kbs3056/proel-sniffer/captures/mso5354/README.md

# description

Raw captures (no logic level translation) made with Rigol MSO5354 in zipped CSV format.

DS0-DS5 - flat 44

DS6 - flat 38

DS0 - Long ring, no pick up, no open.

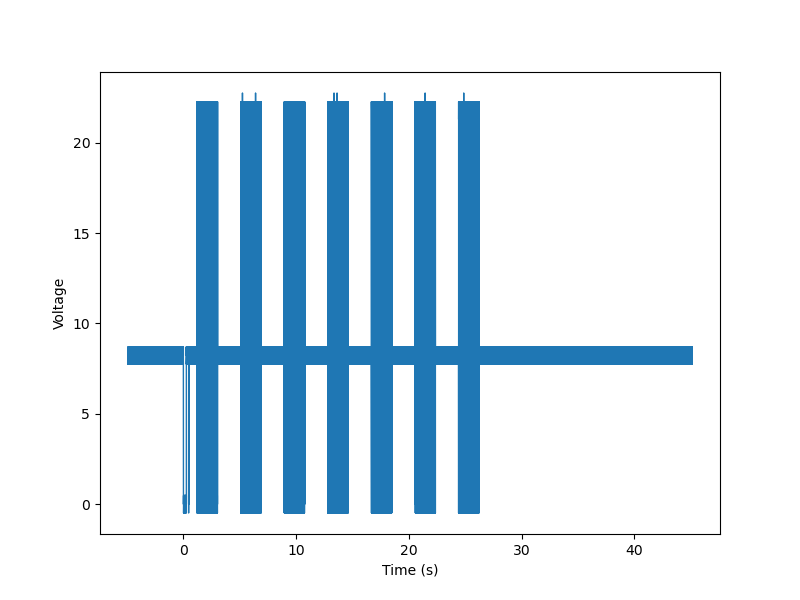
[picture p1: captures/mso5354/ds0.png]
ds0


DS1 - Ring, pick up, "hello", no open.

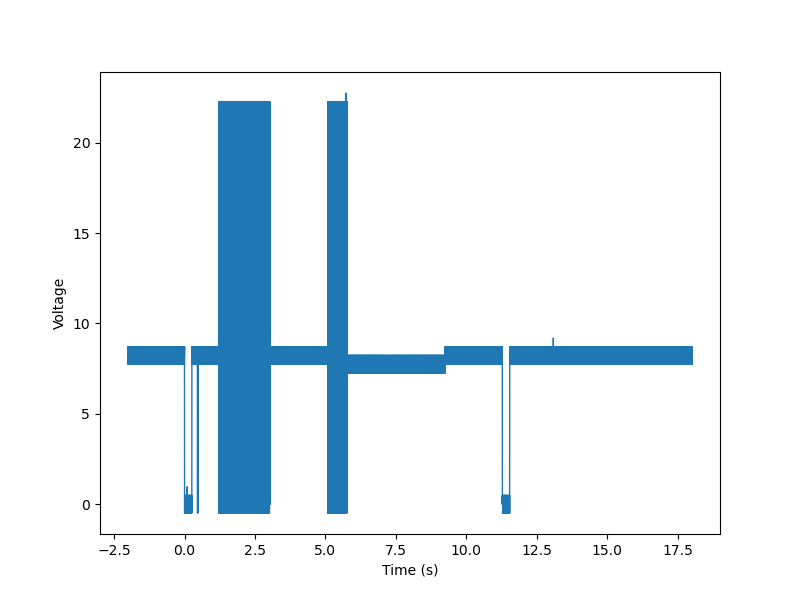
[picture p2: captures/mso5354/ds1.png]
ds1


DS2 - Ring, pick up, "hello", open.

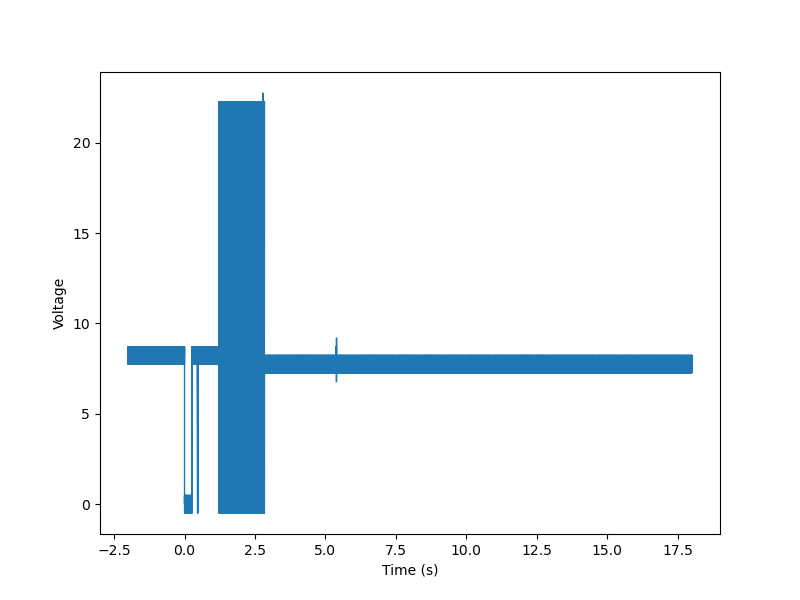
[picture p3: captures/mso5354/ds2.png]
ds2


DS3 - Ring, stopped with the entrance keyboard.

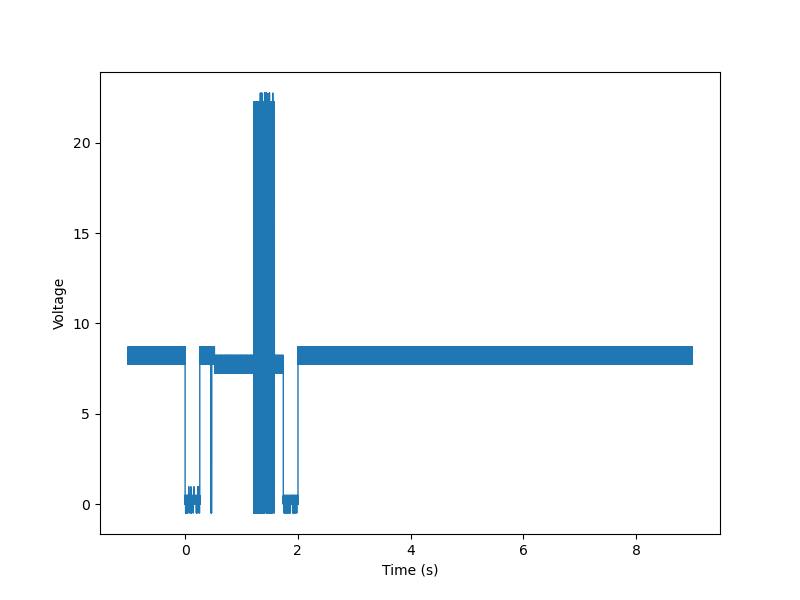
[picture p4: captures/mso5354/ds3.png]
ds3


DS4 - Open the door using a code.

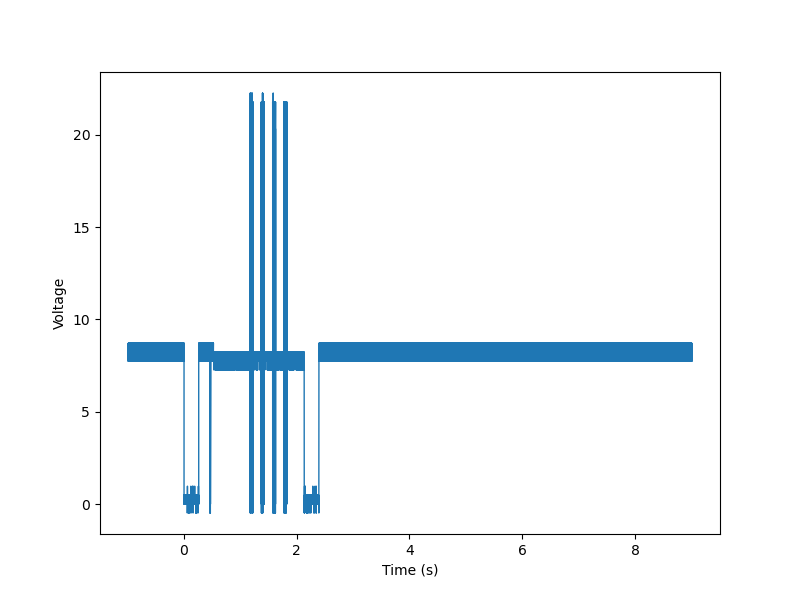
[picture p5: captures/mso5354/ds4.png]
ds4


DS5 - Open the door using a wireless keyfob.

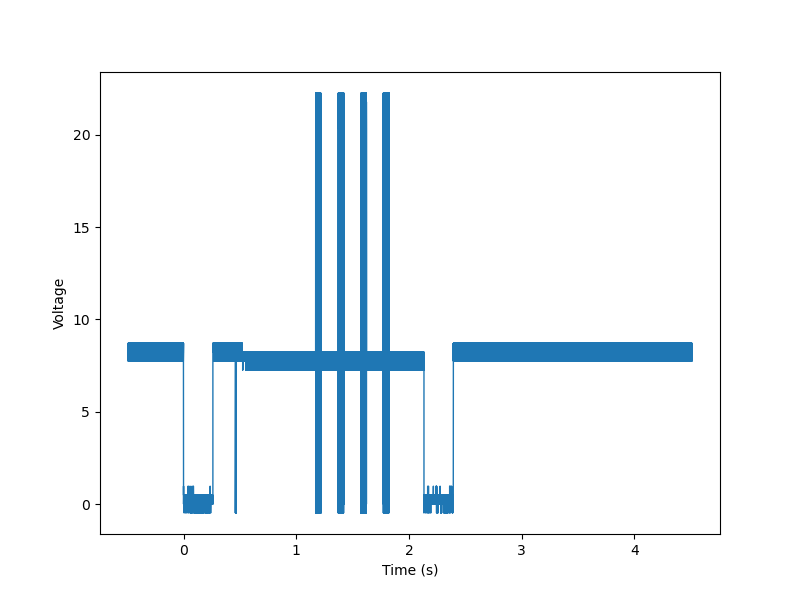
[picture p6: captures/mso5354/ds5.png]
ds5


DS6 - Ring, stop during the second "subring".

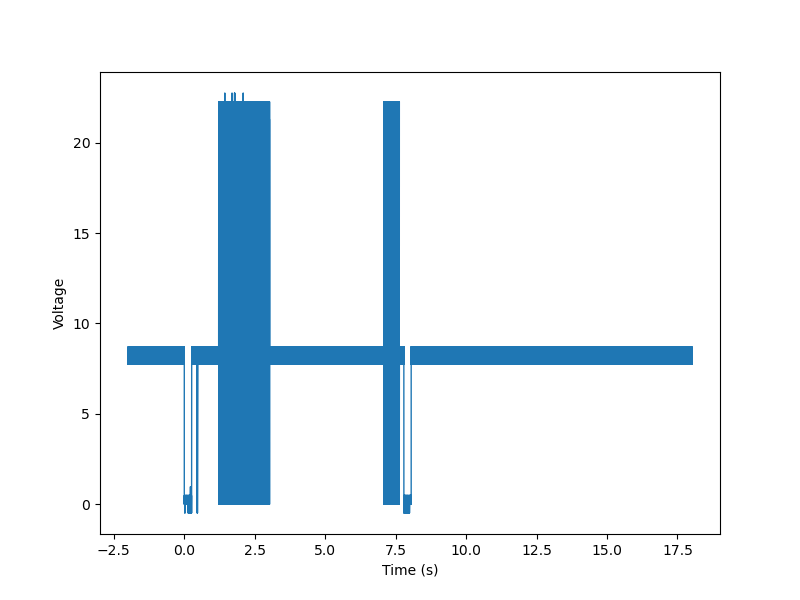
[picture p7: captures/mso5354/ds6.png]
ds6
