kbs3056/proel-sniffer/sniffer-wifi/sniffer-wifi_bot.png

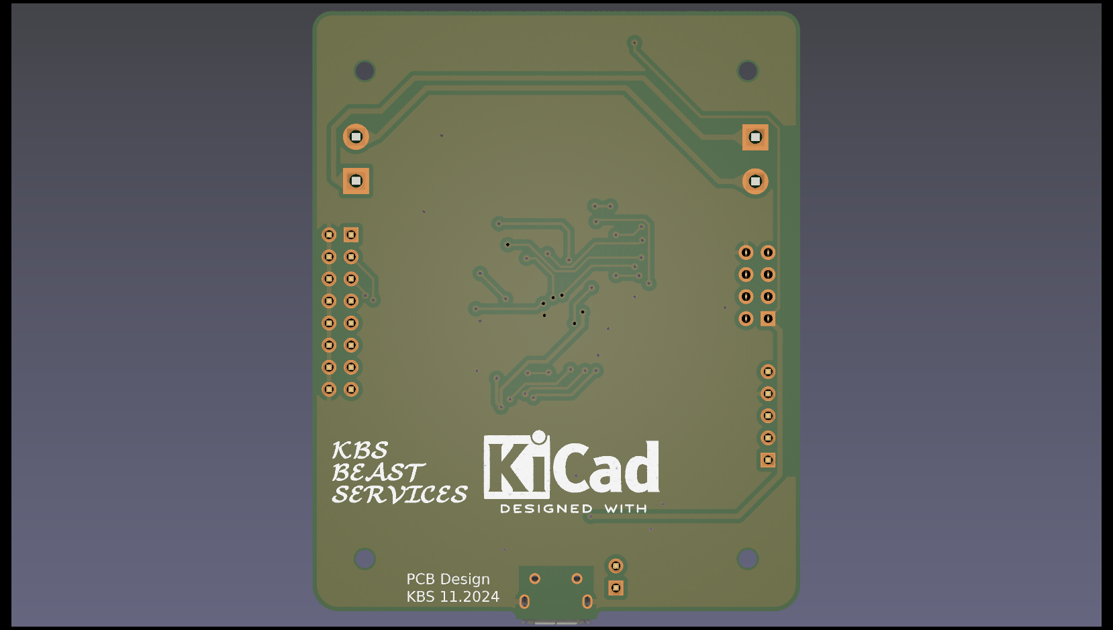
sniffer-wifi/sniffer-wifi_bot.png
