kbs3056/proel-sniffer/sniffer-wifi/sniffer-wifi_top.png

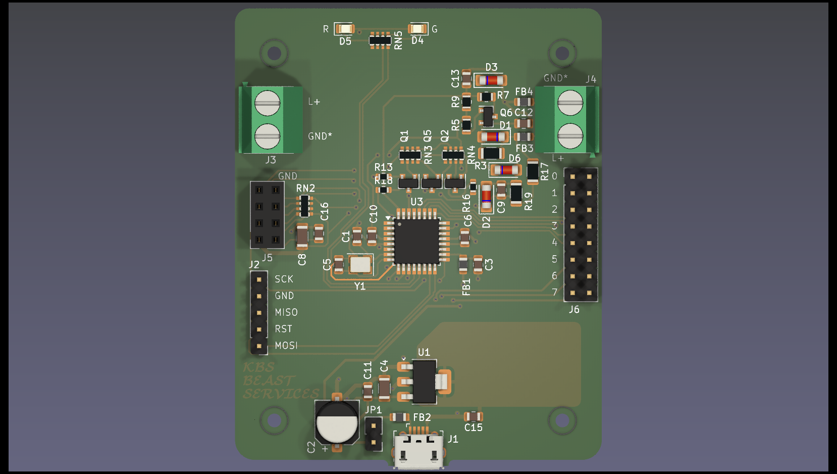
sniffer-wifi/sniffer-wifi_top.png
