kbs3056/proel-sniffer/sch.pdf

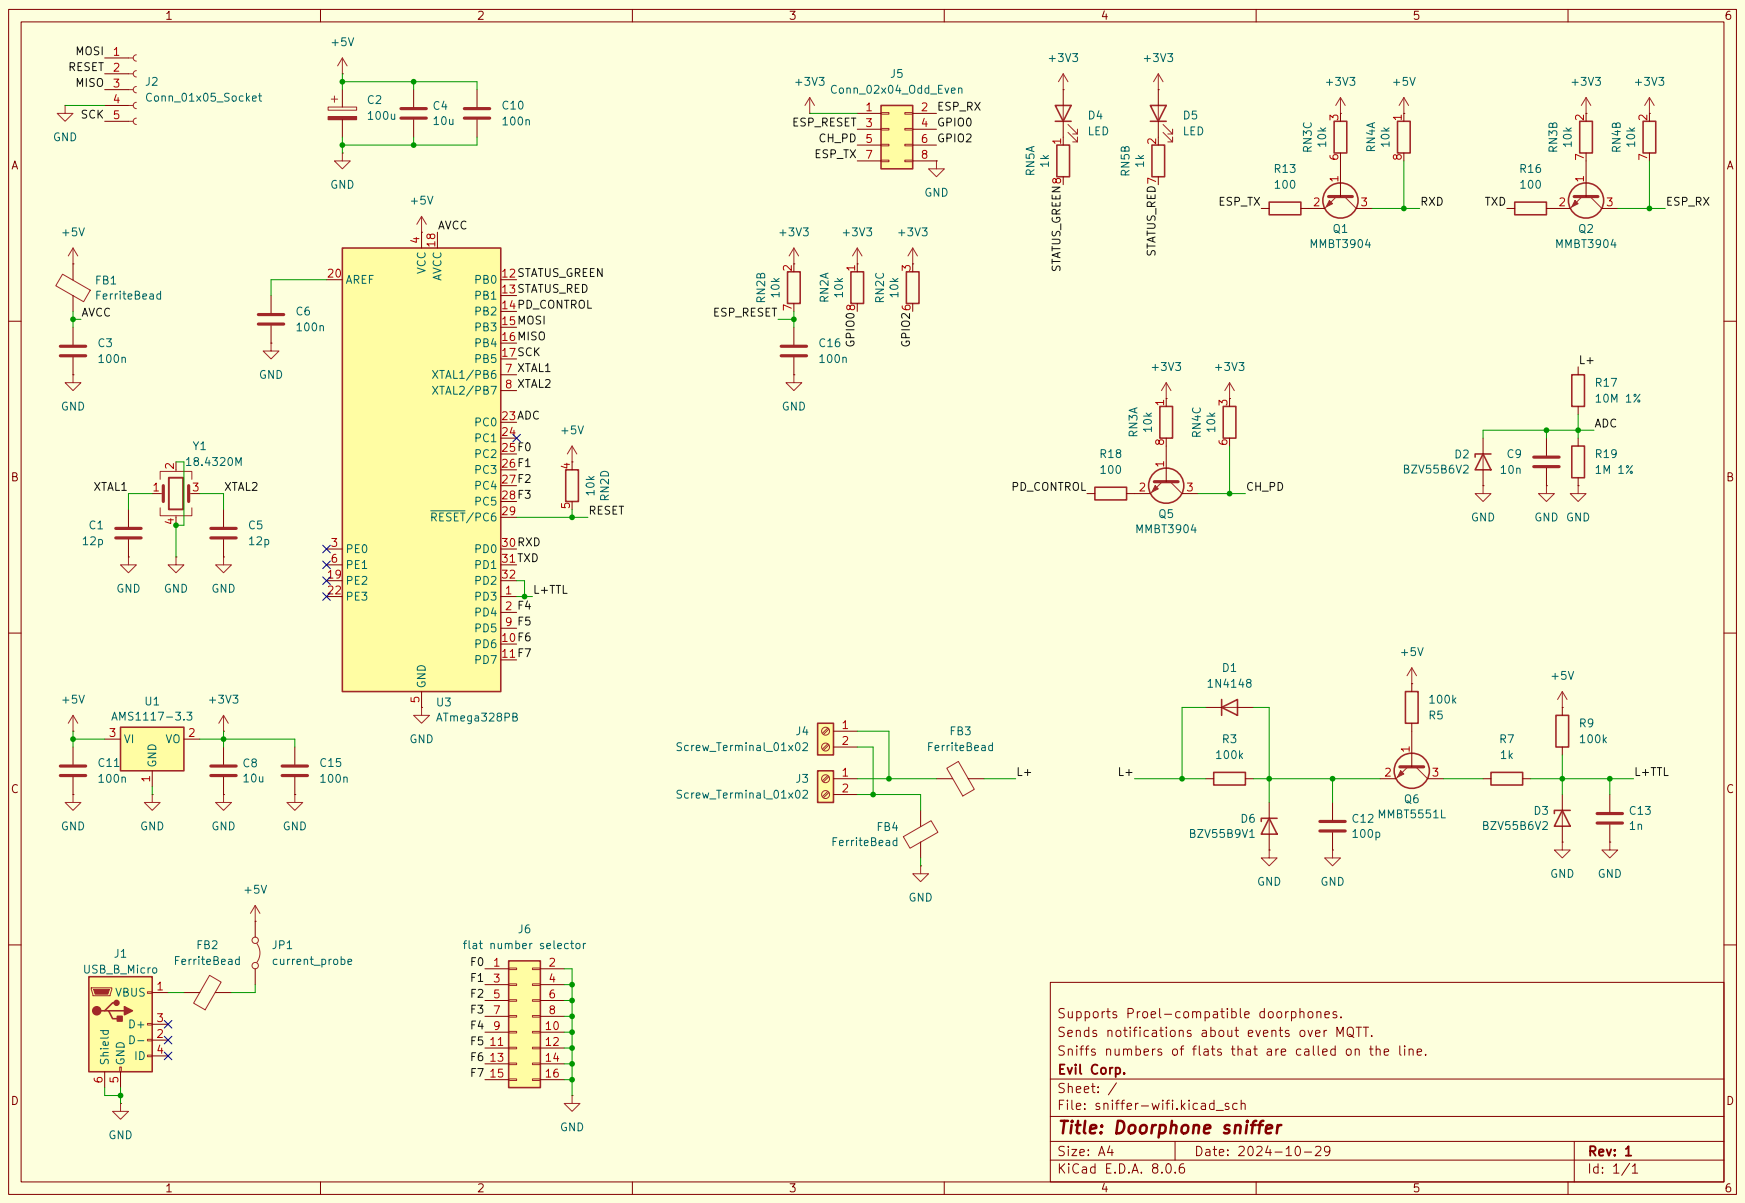
[picture p10: page 1]
