kbs3056/proel-sniffer/sniffer-wifi/sniffer-wifi.kicad_pcb

## KiCad design sniffer-wifi/sniffer-wifi.kicad_pcb (2024-11-15)

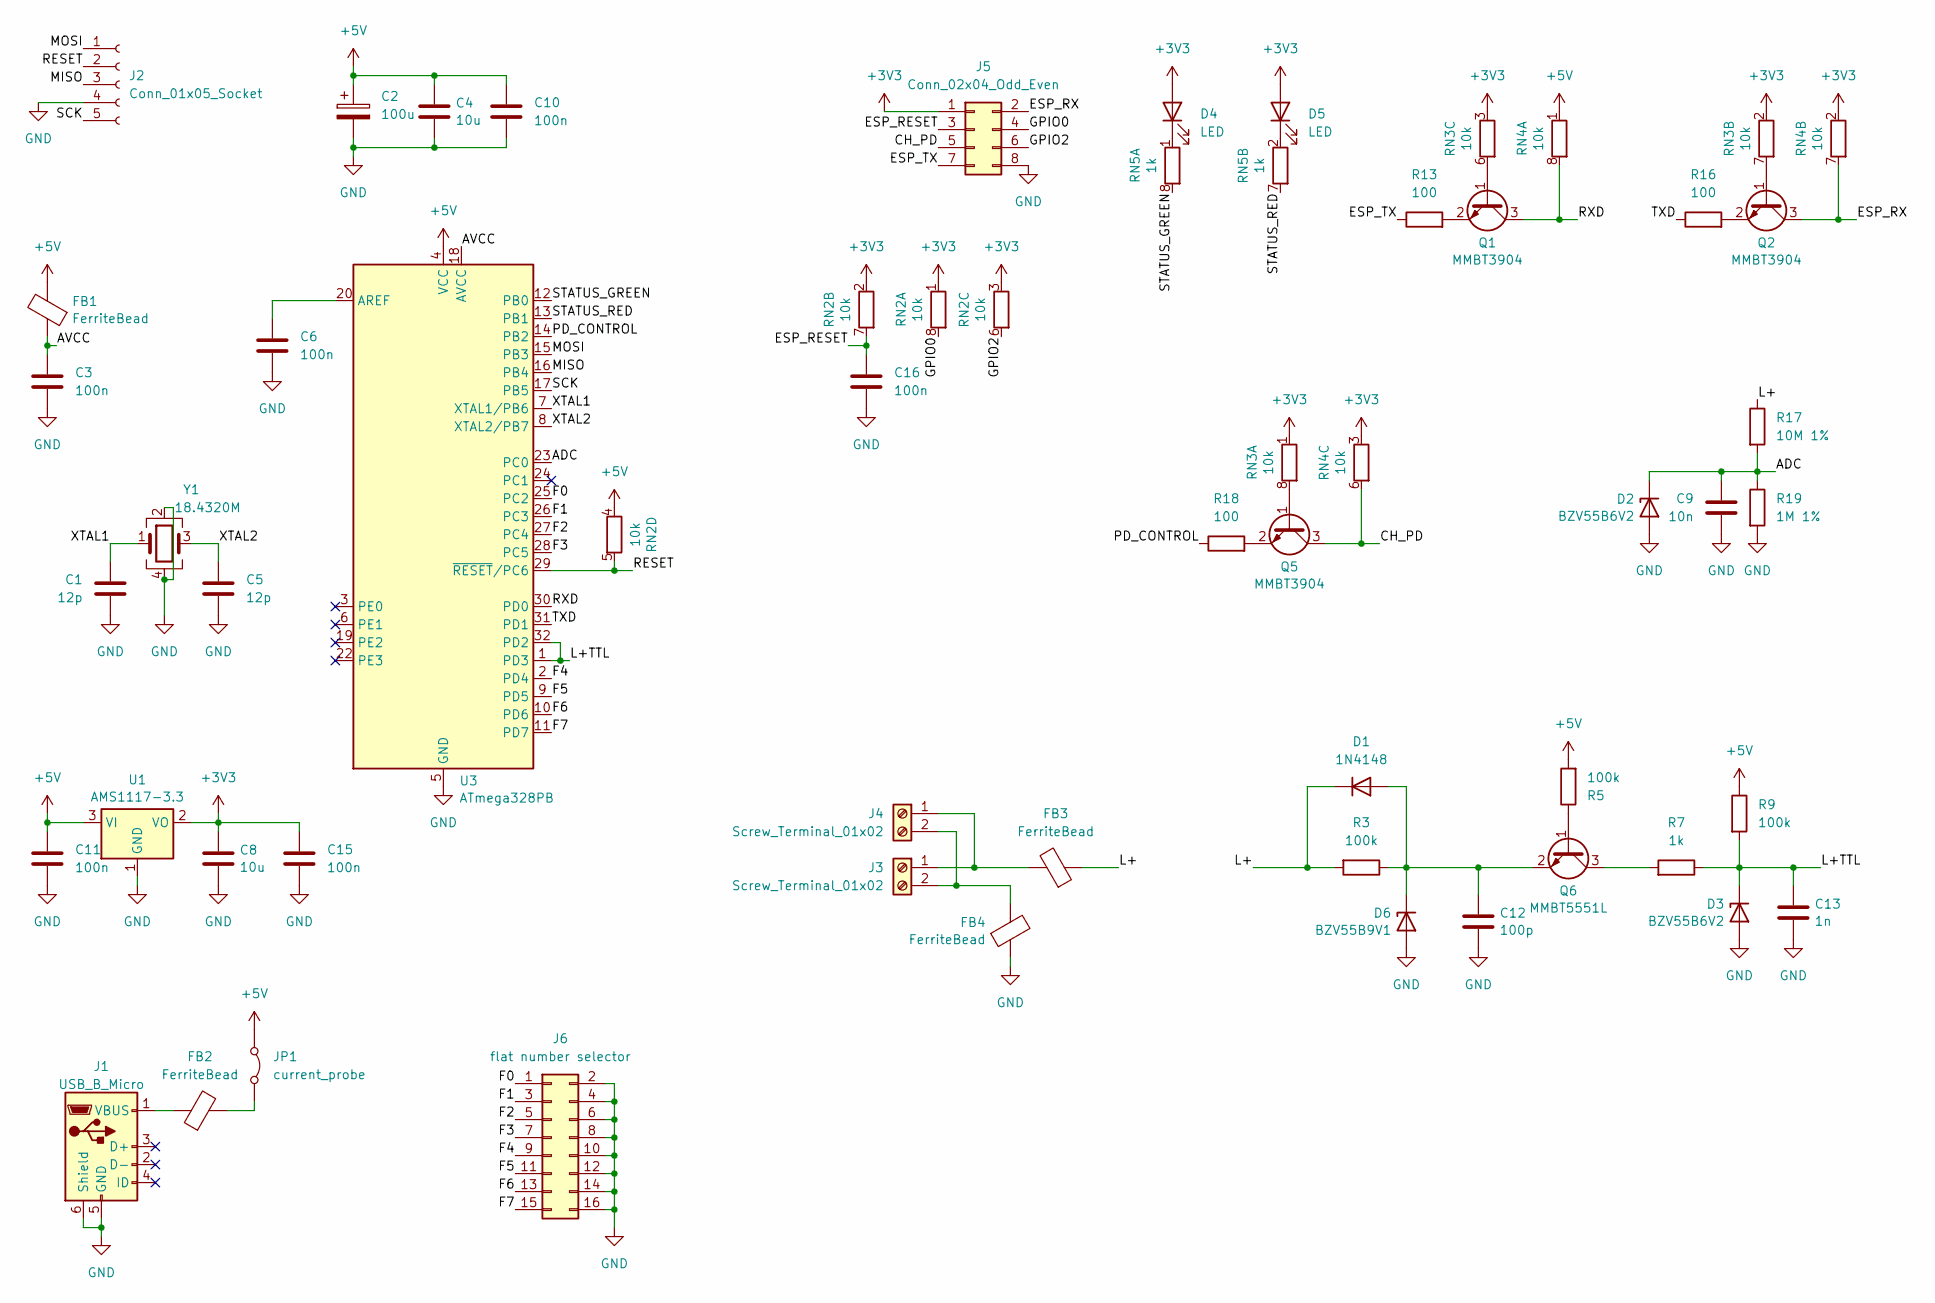
[picture p11: schematic sniffer-wifi.kicad_sch, Doorphone sniffer]

Parts:
C1, C5: 12p; C_0805_2012Metric
C2: 100u; CP_Elec_6.3x9.9
C3, C6, C10, C11, C15, C16: 100n; C_0805_2012Metric
C4, C8: 10u; C_1206_3216Metric
C9: 10n; C_0805_2012Metric
C12: 100p; C_0805_2012Metric
C13: 1n; C_0805_2012Metric
D1: 1N4148; D_MiniMELF
D2, D3: BZV55B6V2; D_MiniMELF
D4, D5: LED; LED_0805_2012Metric
D6: BZV55B9V1; D_MiniMELF
FB1, FB2, FB3, FB4: FerriteBead; L_0805_2012Metric
J1: USB_B_Micro; USB_Micro-B
J2: Conn_01x05_Socket; PinHeader_1x05_P2.54mm_Vertical
J3, J4: Screw_Terminal_01x02; TerminalBlock_bornier-2_P5.08mm
J5: Conn_02x04_Odd_Even; PinSocket_2x04_P2.54mm_Vertical
J6: flat number selector; PinHeader_2x08_P2.54mm_Vertical
JP1: current_probe; PinHeader_1x02_P2.54mm_Vertical
Q1, Q2, Q5: MMBT3904; SOT-23
Q6: MMBT5551L; SOT-23
R3: 100k; R_1206_3216Metric
R5, R9: 100k; R_0805_2012Metric
R7: 1k; R_0805_2012Metric
R13, R16, R18: 100; R_0603_1608Metric
R17: 10M 1%; R_1206_3216Metric
R19: 1M 1%; R_1206_3216Metric
RN2, RN3, RN4: 10k; R_Array_Convex_4x0603
RN5: 1k; R_Array_Convex_4x0603
U1: AMS1117-3.3; SOT-223-3_TabPin2
U3: ATmega328PB; TQFP-32_7x7mm_P0.8mm
Y1: 18.4320M; Crystal_SMD_3225-4Pin_3.2x2.5mm

Connections:
+3V3: C8.1, C15.1, D4.2 (A), D5.2 (A), J5.1, RN2.1 (R1.1), RN2.2 (R2.1), RN2.3 (R3.1), RN3.1 (R1.1), RN3.2 (R2.1), RN3.3 (R3.1), RN4.2 (R2.1), RN4.3 (R3.1), U1.2 (VO)
+5V: C2.1, C4.1, C10.1, C11.1, FB1.2, JP1.1 (A), R5.2, R9.1, RN2.4 (R4.1), RN4.1 (R1.1), U1.3 (VI), U3.4 (VCC)
/ADC: C9.1, D2.1 (K), R17.2, R19.1, U3.23 (PC0)
/AVCC: C3.1, FB1.1, U3.18 (AVCC)
/CH_PD: J5.5, Q5.3 (C), RN4.6 (R3.2)
/ESP_RESET: C16.1, J5.3, RN2.7 (R2.2)
/ESP_RX: J5.2, Q2.3 (C), RN4.7 (R2.2)
/ESP_TX: J5.7, R13.1
/F0: J6.1, U3.25 (PC2)
/F1: J6.3, U3.26 (PC3)
/F2: J6.5, U3.27 (PC4)
/F3: J6.7, U3.28 (PC5)
/F4: J6.9, U3.2 (PD4)
/F5: J6.11, U3.9 (PD5)
/F6: J6.13, U3.10 (PD6)
/F7: J6.15, U3.11 (PD7)
/GPIO0: J5.4, RN2.8 (R1.2)
/GPIO2: J5.6, RN2.6 (R3.2)
/L+: D1.1 (K), FB3.1, R3.2, R17.1
/L+TTL: C13.1, D3.1 (K), R7.1, R9.2, U3.1 (PD3), U3.32 (PD2)
/MISO: J2.3, U3.16 (PB4)
/MOSI: J2.1, U3.15 (PB3)
/PD_CONTROL: R18.1, U3.14 (PB2)
/RESET: J2.2, RN2.5 (R4.2), U3.29 (~RESET/PC6)
/RXD: Q1.3 (C), RN4.8 (R1.2), U3.30 (PD0)
/SCK: J2.5, U3.17 (PB5)
/STATUS_GREEN: RN5.8 (R1.2), U3.12 (PB0)
/STATUS_RED: RN5.7 (R2.2), U3.13 (PB1)
/TXD: R16.1, U3.31 (PD1)
/XTAL1: C1.1, U3.7 (XTAL1/PB6), Y1.1
/XTAL2: C5.1, U3.8 (XTAL2/PB7), Y1.3
GND: C1.2, C2.2, C3.2, C4.2, C5.2, C6.2, C8.2, C9.2, C10.2, C11.2, C12.2, C13.2, C15.2, C16.2, D2.2 (A), D3.2 (A), D6.2 (A), FB4.1, J1.5 (GND), J1.6 (Shield), J2.4, J5.8, J6.2, J6.4, J6.6, J6.8, J6.10, J6.12, J6.14, J6.16, R19.2, U1.1 (GND), U3.5 (GND), U3.21 (GND), Y1.2, Y1.4
unnamed: C12.1, D1.2 (A), D6.1 (K), Q6.2 (E), R3.1
unnamed: D4.1 (K), RN5.1 (R1.1)
unnamed: D5.1 (K), RN5.2 (R2.1)
unnamed: FB2.1, J1.1 (VBUS)
unnamed: FB3.2, J3.1, J4.1
unnamed: FB4.2, J3.2, J4.2
unnamed: FB2.2, JP1.2 (B)
unnamed: Q1.1 (B), RN3.6 (R3.2)
unnamed: Q1.2 (E), R13.2
unnamed: Q2.1 (B), RN3.7 (R2.2)
unnamed: Q2.2 (E), R16.2
unnamed: Q5.1 (B), RN3.8 (R1.2)
unnamed: Q5.2 (E), R18.2
unnamed: Q6.1 (B), R5.1
unnamed: Q6.3 (C), R7.2
unnamed: C6.1, U3.20 (AREF)

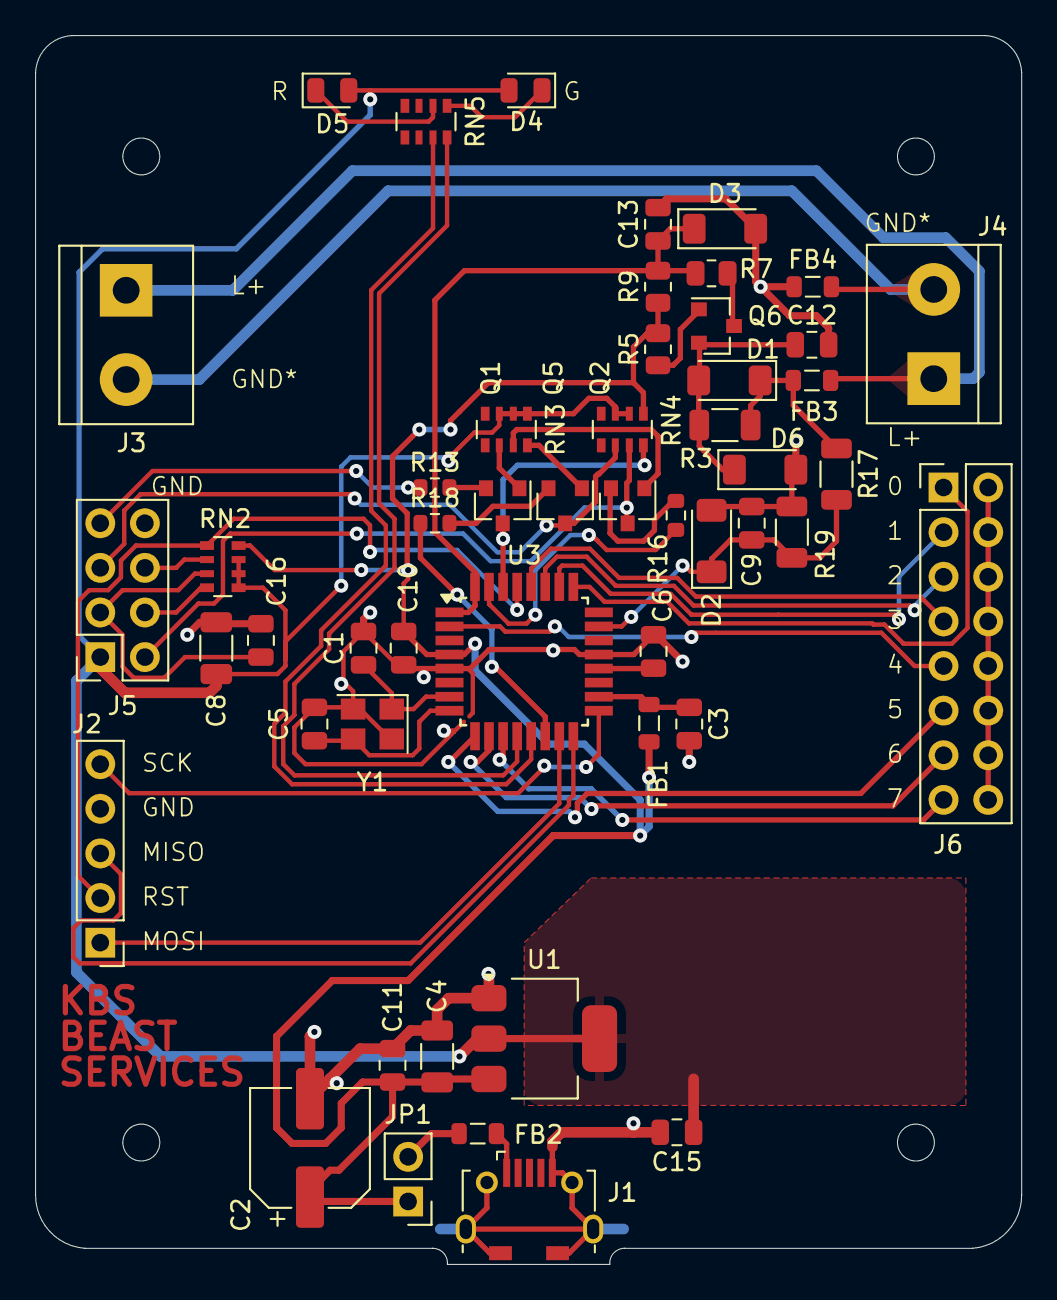
[picture p12: board sniffer-wifi.kicad_pcb from above]

Board: 2 copper layers, 56.1 x 70.0 mm, 55 parts (0 on the bottom side), 48 nets.

Other parts of the board:
REF1, REF2, REF3, REF4: MountingHole_2.1mm
