kbs3056/proel-sniffer/(commit log)

2024-11-15 Add PCB design
    [sniffer-wifi.kicad_pcb, sniffer-wifi.kicad_sch]
2024-11-15 Add schematic pdf
